MaprilBear/Keebi/KeebiPCB.png

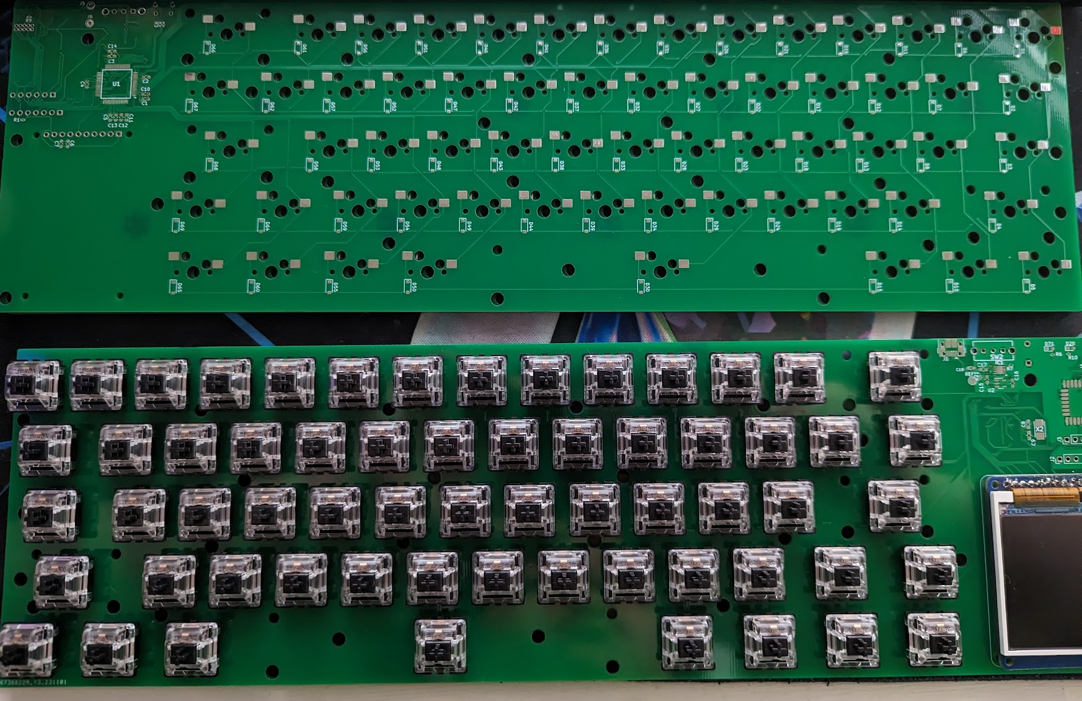
KeebiPCB.png
