MaprilBear/Keebi/sw/BGM220P/bluetooth_hid_keyboard/images/create_project.png

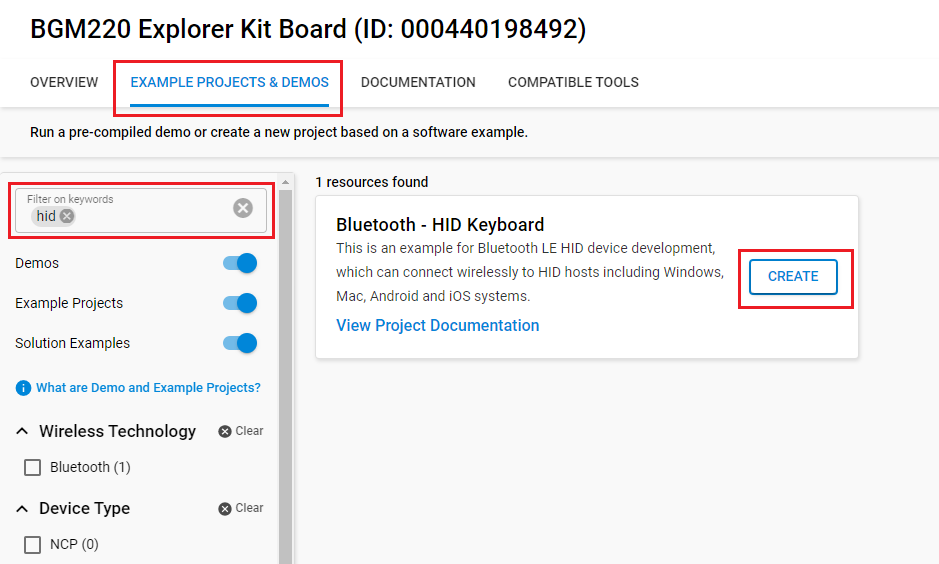
sw/BGM220P/bluetooth_hid_keyboard/images/create_project.png
