MaprilBear/Keebi/sw/BGM220P/bluetooth_hid_keyboard/images/logs.png

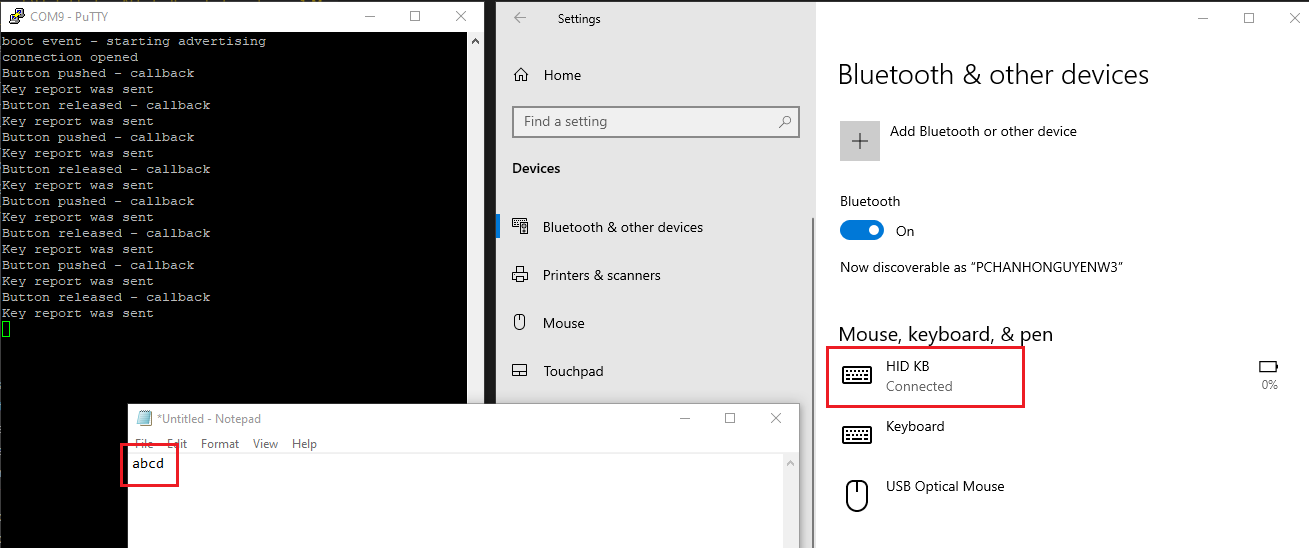
sw/BGM220P/bluetooth_hid_keyboard/images/logs.png
