MaprilBear/Keebi/BOM.xlsx

Sheet: Parts
Bill of Materials |  |  | 2022-03-10 | "not free" means you have to buy it |  | "free sample" means you have to order it
EE445L Spring 2022 |  |  | EE445L pays for the PCB | "Cabinet means in one of the six black cabinets in professsor's office (bring a print out of your SCH")
 |  |  | Items counting against the budget are in YELLOW | "Professor" means ask your professor quantity and style will vary (bring a print out of your SCH circuit)
Qty Note | REF DES Note (http://projects.ece.utexas.edu/valvano/wiki/doku.php?id=pcbartist:schematics) |  |  | "Box means in box in your professor's office (bring a print out of your SCH circuit) |  |  |  | TOTAL | $160.16 | Budget Total | $72.65 | ✨🎵Just ignore the stabs 🎵✨
Quantity | REF DES | Type | Description | Manufacturer | Mfg. P/N | Distributor | P/N | Unit cost | Cost |  | Where to get it? | Inventory
0 |  | ASM | 8-ohm speaker |  |  | AllElectronics | SK-840 | $0.60 | $0.00 | Speaker | professor | https://www.allelectronics.com/item/sk-840/speaker-8-ohm-40mm/1.html
0 |  | ASM | 9V battery snap, T-type |  |  | AllElectronics | BST-61 | $0.50 | $0.00 | Jumper2 | Box
0 |  | ASM | Black case, 5.5" x 2.6" x 1.1" | Hammond | 1593YALBK | Mouser | 546-1593YALBK | $8.50 | $0.00 |  |  | http://www.hammondmfg.com/pdf/1593Y.pdf
0 |  | ASM | Black Case 5.620" x 3.250" X 1.500" | Serpac | 151 | Digikey | SR151B-ND | $10.88 | $0.00 |  | professor
0 |  | ASM | Black case, 7.5" by 4.3" by 2.2" | Hammond | 1591ESBK | Mouser | 546-1591ES-BK | $8.71 | $0.00 |  | Box | http://www.hammondmfg.com/pdf/1591E.pdf
0 |  | ASM | Electret microphone | Panasonic |  | AllElectronics | MIKE-79 | $0.50 | $0.00 | electret | Cabinet
0 |  | CAP | Ceramic, X7R, 20%, 1 uF |  |  | Jameco | 81509 | $0.35 | $0.00 | Ceramic0.2 | Cabinet
0 |  | CAP | Ceramic, Z5U, -20/+80%, 0.47 uF | Kemet | C320C474M5U5TA | Digikey | 399-4309-ND | $0.40 | $0.00 | Ceramic | Cabinet
0 |  | CAP | Ceramic, Z5U, -20/+80%, 0.1 uF |  |  | Digikey | 399-4151-ND | $0.04 | $0.00 | Ceramic | Cabinet
0 |  | CAP | Ceramic, Z5U, -20/+80%, 0.033 uF |  |  | Digikey | 399-4298-ND | $0.40 | $0.00 | Ceramic | Cabinet
0 |  | CAP | Ceramic, Z5U, -20/+80%, 0.027uF |  |  |  |  | $0.40 | $0.00 | Ceramic | Cabinet
0 |  | CAP | Ceramic, Z5U, -20/+80%, 0.01 uF |  |  | Digikey | 399-4148-ND | $0.40 | $0.00 | Ceramic | Cabinet
0 |  | CAP | Ceramic, Z5U, -20/+80%, 4.7 nF |  |  | Digikey | 399-4188-ND | $0.40 | $0.00 | Ceramic | Cabinet
0 |  | CAP | Ceramic, Z5U, -20/+80%, 2.2 nF |  |  |  |  | $0.40 | $0.00 | Ceramic | Cabinet
0 |  | CAP | Ceramic, Z5U, -20/+80%, 1 nF |  |  |  |  | $0.40 | $0.00 | Ceramic | Cabinet
0 |  | CAP | Ceramic Z5U, -20/+80%, 470 pF |  |  |  |  | $0.03 | $0.00 | Ceramic | Cabinet
0 |  | CAP | Ceramic Z5U, -20/+80%, 330 pF |  |  |  |  | $0.03 | $0.00 | Ceramic | Cabinet
0 |  | CAP | Ceramic Z5U, -20/+80%, 220 pF |  |  |  |  | $0.03 | $0.00 | Ceramic | Cabinet
0 |  | CAP | Ceramic Z5U, -20/+80%, 100 pF |  |  |  |  | $0.03 | $0.00 | Ceramic | Cabinet
0 |  | CAP | Ceramic Z5U, -20/+80%, 22 pF |  |  |  |  | $0.03 | $0.00 | Ceramic | Cabinet
0 |  | CAP | Ceramic C0G, 10%, 10 pF | Murata 50V 5% | RDE5C1H100J0P1H03B | Digikey | 490-8629-ND | $0.31 | $0.00 | Ceramic | Cabinet | not required, we expect most students will create a system with the LaunchPad
0 |  | CAP-Tant | Tantalum, 16V, 20% 2.2 uF | AVX Corporation | TAP225M016CCS | Digikey | 478-8819-ND | $0.29 | $0.00 | tantalum | Cabinet
0 |  | CAP-Tant | Tantalum, 16V, 10% 4.7 uF |  |  | Digikey | 478-1904-ND | $0.22 | $0.00 | tantalum | Cabinet
0 |  | CAP-Tant | Tantalum, 20V, 10%, 1 uF |  |  | Digikey | 478-1833-ND | $0.32 | $0.00 | tantalum | Cabinet
0 |  | CAP-Tant | Tantalum, 20V 10%, 10uF |  |  | Digikey | 478-1840-ND | $0.56 | $0.00 | tantalum | Cabinet
0 |  | CAP-Tant | Tantalum, 35V, 10%, 0.47 uF |  |  | Jameco | 33531 | $0.19 | $0.00 | tantalum | Cabinet
0 |  | CAP-Elec | Electrolytic, 16V, 100 uF, cap 20%, ESR=20mV |  |  | Mouser | 661-APSF160E101MF05S | $0.38 | $0.00 | tantalum | Cabinet
0 |  | CON | 2 to 40 pin 0.1 in header (price per pin) |  |  | AllElectronics | SHS-40 | $0.02 | $0.00 | Jumper2 | Cabinet | https://www.allelectronics.com/item/shs-40/1-x-40-header-0.1-spacing/1.html
0 |  | CON | 2-pin shrouded header (mates with SBC-2) |  |  | AllElectronics | SBH-2 | $0.10 | $0.00 | Jumper2 | Cabinet | https://www.allelectronics.com/item/sbh-2/header-for-small-battery-conn-2.5mm-spacing/1.html
0 |  | DIODE | 1N914 diode | Fairchild | 1N914 | Digikey | 1N914B-ND | $0.05 | $0.00 | goes with SBH-2 | Cabinet | https://www.allelectronics.com/item/sbc-2/small-battery-connector-2.5mm-spacing/1.html
0 |  | CON | 2-pin shorting jumper, attaches to 0.1" male-male header | Harwin | M7581-05 | Mouser | 855-M7581-05 | $0.11 | $0.00 | goes with Jumper2 | Cabinet
0 |  | CON | Test point, black | Keystone Electronics | 5001 | Digikey | 36-5001K-ND | $0.23 | $0.00 | testpoint | Cabinet
0 |  | CON | Test point, orange | Keystone Electronics | 5003 | Digikey | 36-5003K-ND | $0.23 | $0.00 | testpoint | Cabinet
0 |  | CON | Test point, yellow | Keystone Electronics | 5004 | Digikey | 36-5004K-ND | $0.23 | $0.00 | testpoint | Cabinet
0 |  | CON | Test point, white | Keystone Electronics | 5002 | Digikey | 36-5002K-ND | $0.23 | $0.00 | testpoint | Cabinet
0 |  | CON | Test point, blue | Keystone Electronics | 5117 | Digikey | 36-5117-ND | $0.23 | $0.00 | testpoint | Cabinet
0 |  | CON | Test point, green | Keystone Electronics | 5116 | Digikey | 36-5116-ND | $0.23 | $0.00 | testpoint | Cabinet
0 |  | CON | Test point, red | Keystone Electronics | 5000 | Digikey | 36-5000K-ND | $0.23 | $0.00 | testpoint | Cabinet
0 |  | CON | 10-pin female connector | SamTec | BCS-110-L-S-TE | Digikey | SAM1011-10-ND | $1.98 | $0.00 |  | Cabinet
0 |  | CON | Socket for micro SD card | Molex | 473340001 | Digikey | WM3288CT-ND | $4.02 | $0.00 | MicroSD Slot | Cabinet | do not use, rather included on ST7735
0 |  | CON | USB Mini-B socket, board mount, surface mount | Molex | 56579-0576 | Mouser | 538-56579-0576 | $2.46 | $0.00 | USB_Mini-B | Cabinet
0 |  | LED | Red 1.6V 1mA 5mm diffused | Avago Technologies | HLMP-D150 | Digikey | 516-1323-ND | $0.29 | $0.00 | USB_Micro-B | Cabinet
0 |  | CON | USB Mini-B socket, board mount, through hole | Molex | 54819-0519 | Digikey | WM17115-ND | $0.65 | $0.00 | USB_Mini-B | Cabinet
0 |  | CON | BoosterPack connector | FCI | 67996-220HLF | Mouser | 609-3243-ND | $0.26 | $0.00 | BoosterPack | Cabinet
0 |  | CON | Logic Analyzer connector | FCI | 68021-208HLF | Digikey | 609-3344-ND | $0.27 | $0.00 | LogicAnalyzer | Cabinet
1 |  | CON | 2-pin battery cable (mates with SBH-2) |  |  | AllElectronics | SBC-2 | $0.27 | $0.27 | JTAG | Cabinet
0 |  | CON | 10 pin 2mm socket for Xbee (need two) | SamTec | SQT-110-01-F-S | Digikey | SAM9989-ND | $2.70 | $0.00 | XbeeModule | Cabinet
1 |  | CON | Micro USB Type B, surface mount | Hirose Connector | ZX62D-B-5PA8(30) | Mouser | 798-ZX62D-B-5PA830 | $0.47 | $0.47 | TM4C123GH6PM |  | not required, we expect most students will create a system with the LaunchPad
1 |  | CRYS | NX5032GA-16.000000 | NDK | NX5032GA-16.000000 | Digikey | 644-1037-1-ND | $0.51 | $0.51 | XTAL/NX5032 | Cabinet | not required, we expect most students will create a system with the LaunchPad
1 |  | CON | JTAG 1 by 5 male header |  |  |  |  | $0.29 | $0.29 | 1N914 | Cabinet
0 |  | IC | LM2937 3.3 V regulator TO220, 500mA | TI | LM2937ET-3.3/NOPB | Digikey | LM2937ET-3.3-ND | $1.17 | $0.00 | LM2937-3.3 | Cabinet
0 |  | IC | LP2950 3.3V regulator, 100 mA TO-92 | TI | LP2950-33LPRE3 | Digikey | 296-31455-1-ND | $0.19 | $0.00 | LP2950-CZ-3.3 | Cabinet
0 |  | IC | 78M05 500mA 5V TO-220 regulator | National | LM78M05 | Jameco | 192233 | $0.19 | $0.00 | LM7805CT | Cabinet
0 |  | IC | OPA4350 quad op amp | TI | OPA4350UA | Mouser | 595-OPA4350UA | $12.15 | $0.00 | OPA4350 | not free
0 |  | IC | TLV5616 12-bit DAC | TI | TLV5616CP | Mouser | 595-TLV5616CP | $10.09 | $0.00 | TLV5616 | not free
0 |  | IC | TLV5618 dual 12-bit DAC | TI | TLV5618 | Mouser | TLV5618ACP | $14.18 | $0.00 | TLV5618 | not free
0 |  | IC | INA122P instrumentation amp | TI | INA122P | Mouser | 595-INA122P | $9.09 | $0.00 | INA122 | Cabinet or free sample
0 |  | IC | OPA2350 dual op amp | TI | OPA2350PA | obsolete |  |  | $0.00 | OPA2350 | Cabinet or free sample |  |  | 1 KD
0 |  | IC | TLC2274 quad op amp | TI | TLC2274ACN | Mouser | 595-TLC2274ACN | $3.06 | $0.00 | TLC2274 | not free |  |  | 2 HD
0 |  | IC | TPA731 audio amp (pin 1 low) 700mW | TI | TPA731D | Mouser | 595-TPA731D | $2.90 | $0.00 | TPA731 | not free |  |  | 3 AD
0 |  | IC | TPA751 audio amp (pin 1 high) 700mW | TI | TPA751D | Mouser | 595-TPA751D | $2.31 | $0.00 | TPA731 | not free |  |  | 4 JD
0 |  | IC | LM4041CILPR shunt diode reference | TI | LM4041CILPR | Mouser | 595-LM4041CILPR | $1.21 | $0.00 | LM4041 | Cabinet or free sample |  |  | 5 CD
0 |  | IC | L293 Motor H bridge | TI | L293NE | Digikey | 296-9519-5-ND | $3.50 | $0.00 | L293 | Cabinet |  |  | 7 MD
0 |  | IC | 74HC595 |  |  | Jameco | 46105 | $0.40 | $0.00 |  | Cabinet |  |  | 8 ED
0 |  | IC | 74HC165 |  |  | Jameco | 45495 | $0.30 | $0.00 |  | Cabinet |  |  | 9 FD
0 |  | IC | 74HCT125N | TI | SN74HCT125N | Mouser | 595-SN74HCT125N | $0.53 | $0.00 |  | Cabinet
0 |  | IC | RS232 driver | STMicroelectronics | ST232CN | Jameco | 2001171 | $0.58 | $0.00 | ST232 | Cabinet |  |  | 0 ND
0 |  | JACK | DC Power MALE 2.1mm |  |  | Jameco | 101179 | $0.55 | $0.00 | PowerJack | Cabinet |  |  | * LD
0 |  | JACK | Stereo Jack, or audio jack |  |  | AllElectronics | MJW-12 | $0.09 | $0.00 | HeadphoneJack | Cabinet |  | 87YY3212A
0 |  | KEY | 3 by 4 common bus (D), keypad | Grayhill | 87YY3212A-506 |  |  | $2.99 | $0.00 | 87YY3212A | Box | http://docs.bgmicro.com/pdf/swt1109.pdf
1 |  | LCD | 18-bit color 128*160 1.8" TFT LCD display | Sitronix | ST7735R | Adafruit | 358 | $19.96 | $19.96 | LEDT1.75 | Cabinet
0 |  | LED | Yellow 2mA 5mm diffused | Avago Technologies | HLMP-4719 | Digikey | 516-1326-ND | $0.29 | $0.00 | LEDT1.75 | Cabinet
0 |  | LED | Orange 10mA 5mm diffused | Avago Technologies | HLMP-D401 | Digikey | 516-1330-ND | $0.29 | $0.00 | LEDT1.75 | Cabinet
0 |  | LED | Blue 10mA 5mm diffused |  |  |  |  | $0.99 | $0.00 | LEDT1.75 | Cabinet | warning, the blue LEDs are very bright
1 |  | PCB | PCB plus shipping | JLCPCB |  | JLCPCB |  | $40.00 | $40.00
0 |  | POT | 20K LINEAR SLIDE POT | Bourns | PTA2043-2015CPB103 | Mouser | 652-PTA20432015CPB10 | $1.28 | $0.00 |  | Cabinet
0 |  | POT | 10 K one-turn potentiometer |  |  |  |  | $0.15 | $0.00 | SquarePot | Professor
0 |  | POT | 20 K one-turn potentiometer |  |  |  |  | $0.15 | $0.00 | SquarePot | Professor
0 |  | RES | Carbon 1/6W, 5%, 100 | Yageo | CFR-12JB-100R | Digikey | 100EBK-ND | $0.02 | $0.00 | 0.125Wresistor | Cabinet
0 |  | RES | Carbon 1/6W, 5%, 220 | Yageo | CFR-12JB-220R | Digikey | 220EBK-ND | $0.02 | $0.00 | 0.125Wresistor | Cabinet
0 |  | RES | Carbon 1/6W, 5%, 270 | Yageo | CFR-12JB-270R | Digikey | 270EBK-ND | $0.02 | $0.00 | 0.125Wresistor | Cabinet
0 |  | RES | Carbon 1/6W, 5%, 330 | Yageo | CFR-12JB-330R | Digikey | 330EBK-ND | $0.02 | $0.00 | 0.125Wresistor | Cabinet
0 |  | RES | Carbon 1/6W, 5%, 470 | Yageo | CFR-12JB-470R | Digikey | 470EBK-ND | $0.02 | $0.00 | 0.125Wresistor | Cabinet
0 |  | RES | Carbon 1/6W, 5%, 510 | Yageo | CFR-12JB-510R | Digikey | 510EBK-ND | $0.02 | $0.00 | 0.125Wresistor | Cabinet
0 |  | RES | Carbon 1/6W, 5%, 680 | Yageo | CFR-12JB-680R | Digikey | 680EBK-ND | $0.02 | $0.00 | 0.125Wresistor | Cabinet
0 |  | RES | Carbon 1/6W, 5%, 820 | Yageo | CFR-12JB-820R | Digikey | 820EBK-ND | $0.02 | $0.00 | 0.125Wresistor | Cabinet
0 |  | RES | Carbon 1/6W, 5%, 1K | Yageo | CFR-12JB-1K0 | Digikey | 1.0KEBK-ND | $0.02 | $0.00 | 0.125Wresistor | Cabinet
0 |  | RES | Carbon 1/6W, 5%, 1.2K | Yageo | CFR-12JB-1K2 | Digikey | 1.2KEBK-ND | $0.02 | $0.00 | 0.125Wresistor | Cabinet
0 |  | RES | Carbon 1/6W, 5%, 1.5K | Yageo | CFR-12JB-1K5 | Digikey | 1.5KEBK-ND | $0.02 | $0.00 | 0.125Wresistor | Cabinet
0 |  | RES | Carbon 1/6W, 5%, 1.8K | Yageo | CFR-12JB-1K8 | Digikey | 1.8KEBK-ND | $0.02 | $0.00 | 0.125Wresistor | Cabinet
0 |  | RES | Carbon 1/6W, 5%, 2.0K | Yageo | CFR-12JB-2K0 | Digikey | 2.0KEBK-ND | $0.02 | $0.00 | 0.125Wresistor | Cabinet
0 |  | RES | Carbon 1/6W, 5%, 2.2K | Yageo | CFR-12JB-2K2 | Digikey | 2.2KEBK-ND | $0.02 | $0.00 | 0.125Wresistor | Cabinet
0 |  | RES | Carbon 1/6W, 5%, 2.7K | Yageo | CFR-12JB-2K7 | Digikey | 2.7KEBK-ND | $0.02 | $0.00 | 0.125Wresistor | Cabinet
0 |  | RES | Carbon 1/6W, 5%, 3.3K | Yageo | CFR-12JB-3K3 | Digikey | 3.3KEBK-ND | $0.02 | $0.00 | 0.125Wresistor | Cabinet
0 |  | RES | Carbon 1/6W, 5%, 3.9K | Yageo | CFR-12JB-3K9 | Digikey | 3.9KEBK-ND | $0.02 | $0.00 | 0.125Wresistor | Cabinet
0 |  | RES | Carbon 1/6W, 5%, 4.7K | Yageo | CFR-12JB-4K7 | Digikey | 4.7KEBK-ND | $0.02 | $0.00 | 0.125Wresistor | Cabinet
0 |  | RES | Carbon 1/6W, 5%, 5.1K | Yageo | CFR-12JB-5K1 | Digikey | 5.1KEBK-ND | $0.02 | $0.00 | 0.125Wresistor | Cabinet
0 |  | RES | Carbon 1/6W, 5%, 5.6K | Yageo | CFR-12JB-5K6 | Digikey | 5.6KEBK-ND | $0.02 | $0.00 | 0.125Wresistor | Cabinet
0 |  | RES | Carbon 1/6W, 5%, 6.8K | Yageo | CFR-12JB-6K8 | Digikey | 6.8KEBK-ND | $0.02 | $0.00 | 0.125Wresistor | Cabinet
0 |  | RES | Carbon 1/6W, 5%, 8.2K | Yageo | CFR-12JB-8K2 | Digikey | 8.2KEBK-ND | $0.02 | $0.00 | 0.125Wresistor | Cabinet
0 |  | RES | Carbon 1/6W, 5%, 10K | Yageo | CFR-12JB-10K | Digikey | 10KEBK-ND | $0.02 | $0.00 | 0.125Wresistor | Cabinet
0 |  | RES | Carbon 1/6W, 5%, 12K | Yageo | CFR-12JB-12K | Digikey | 12KEBK-ND | $0.02 | $0.00 | 0.125Wresistor | Cabinet
0 |  | RES | Carbon 1/6W, 5%, 15K | Yageo | CFR-12JB-15K | Digikey | 15KEBK-ND | $0.02 | $0.00 | 0.125Wresistor | Cabinet | http://www.kemet.com/kemet/web/homepage/kechome.nsf/vapubfiles/F3101_GoldMax.pdf/$file/F3101_GoldMax.pdf
0 |  | RES | Carbon 1/6W, 5%, 18K | Yageo | CFR-12JB-18K | Digikey | 18KEBK-ND | $0.02 | $0.00 | 0.125Wresistor | Cabinet
0 |  | RES | Carbon 1/6W, 5%, 20K | Yageo | CFR-12JB-20K | Digikey | 20KEBK-ND | $0.02 | $0.00 | 0.125Wresistor | Cabinet
0 |  | RES | Carbon 1/6W, 5%, 22K | Yageo | CFR-12JB-22K | Digikey | 22KEBK-ND | $0.02 | $0.00 | 0.125Wresistor | Cabinet
0 |  | RES | Carbon 1/6W, 5%, 27K | Yageo | CFR-12JB-27K | Digikey | 27KEBK-ND | $0.02 | $0.00 | 0.125Wresistor | Cabinet
0 |  | RES | Carbon 1/6W, 5%, 36K | Yageo | CFR-12JB-36K | Digikey | 36KEBK-ND | $0.02 | $0.00 | 0.125Wresistor | Cabinet
0 |  | RES | Carbon 1/6W, 5%, 33K | Yageo | CFR-12JB-33K | Digikey | 33KEBK-ND | $0.02 | $0.00 | 0.125Wresistor | Cabinet
0 |  | RES | Carbon 1/6W, 5%, 39K | Yageo | CFR-12JB-39K | Digikey | 39KEBK-ND | $0.02 | $0.00 | 0.125Wresistor | Cabinet
0 |  | RES | Carbon 1/6W, 5%, 47K | Yageo | CFR-12JB-47K | Digikey | 47KEBK-ND | $0.02 | $0.00 | 0.125Wresistor | Cabinet
0 |  | RES | Carbon 1/6W, 5%, 51K | Yageo | CFR-12JB-51K | Digikey | 51KEBK-ND | $0.02 | $0.00 | 0.125Wresistor | Cabinet
0 |  | RES | Carbon 1/6W, 5%, 56K | Yageo | CFR-12JB-56K | Digikey | 56KEBK-ND | $0.02 | $0.00 | 0.125Wresistor | Cabinet
0 |  | RES | Carbon 1/6W, 5%, 68K | Yageo | CFR-12JB-68K | Digikey | 68KEBK-ND | $0.02 | $0.00 | 0.125Wresistor | Cabinet
0 |  | RES | Carbon 1/6W, 5%, 82K | Yageo | CFR-12JB-82K | Digikey | 82KEBK-ND | $0.02 | $0.00 | 0.125Wresistor | Cabinet
0 |  | RES | Carbon 1/6W, 5%, 100K | Yageo | CFR-12JB-100K | Digikey | 100KEBK-ND | $0.02 | $0.00 | 0.125Wresistor | Cabinet
0 |  | RES | Carbon 1/6W, 5%, 120K | Yageo | CFR-12JB-120K | Digikey | 120KEBK-ND | $0.02 | $0.00 | 0.125Wresistor | Cabinet
0 |  | RES | Carbon 1/6W, 5%, 150K | Yageo | CFR-12JB-150K | Digikey | 150KEBK-ND | $0.02 | $0.00 | 0.125Wresistor | Cabinet
0 |  | RES | Carbon 1/6W, 5%, 180K | Yageo | CFR-12JB-180K | Digikey | 180KEBK-ND | $0.02 | $0.00 | 0.125Wresistor | Cabinet
0 |  | RES | Carbon 1/6W, 5%, 200K | Yageo | CFR-12JB-200K | Digikey | 200KEBK-ND | $0.02 | $0.00 | 0.125Wresistor | Cabinet
0 |  | RES | Carbon 1/6W, 5%, 220K | Yageo | CFR-12JB-220K | Digikey | 220KEBK-ND | $0.02 | $0.00 | 0.125Wresistor | Cabinet
0 |  | RES | Carbon 1/6W, 5%, 240K | Yageo | CFR-12JB-240K | Digikey | 240KEBK-ND | $0.02 | $0.00 | 0.125Wresistor | Cabinet
0 |  | RES | Carbon 1/6W, 5%, 270K | Yageo | CFR-12JB-270K | Digikey | 270KEBK-ND | $0.02 | $0.00 | 0.125Wresistor | Cabinet
0 |  | RES | Carbon 1/6W, 5%, 330K | Yageo | CFR-12JB-330K | Digikey | 330KEBK-ND | $0.02 | $0.00 | 0.125Wresistor | Cabinet
0 |  | RES | Carbon 1/6W, 5%, 390K | Yageo | CFR-12JB-390K | Digikey | 390KEBK-ND | $0.02 | $0.00 | 0.125Wresistor | Cabinet
0 |  | RES | Carbon 1/6W, 5%, 470K | Yageo | CFR-12JB-470K | Digikey | 470KEBK-ND | $0.02 | $0.00 | 0.125Wresistor | Cabinet
0 |  | RES | Carbon 1/6W, 5%, 510K | Yageo | CFR-12JB-510K | Digikey | 510KEBK-ND | $0.02 | $0.00 | 0.125Wresistor | Cabinet
0 |  | RES | Carbon 1/6W, 5%, 560K | Yageo | CFR-12JB-560K | Digikey | 560KEBK-ND | $0.02 | $0.00 | 0.125Wresistor | Cabinet
0 |  | RES | Carbon 1/6W, 5%, 680K | Yageo | CFR-12JB-680K | Digikey | 680KEBK-ND | $0.02 | $0.00 | 0.125Wresistor | Cabinet
0 |  | RES | Carbon 1/6W, 5%, 820K | Yageo | CFR-12JB-820K | Digikey | 820KEBK-ND | $0.02 | $0.00 | 0.125Wresistor | Cabinet
0 |  | RES | Carbon 1/6W, 5%, 1M | Yageo | CFR-12JB-1M0 | Digikey | 1.0MEBK-ND | $0.02 | $0.00 | 0.125Wresistor | Cabinet
0 |  | RES | Carbon 1/6W, 5%, 10M | Yageo | CFR-12JB-10M | Digikey | 10MEBK-ND | $0.02 | $0.00 | 0.125Wresistor | Cabinet
0 |  | SW | Tactile Switch, surface mount | C&K Components | KSC353JLFG | Mouser | 611-KSC353JLFG | $0.86 | $0.00 | KSC353JLFG | Cabinet
0 |  | SW | B3F tactile push button switch | Omron Electronics | B3F-1052 | Digikey | SW405-ND | $0.17 | $0.00 | B3F-1050 | Cabinet
0 |  | SW | Black Off board momentary push buttom |  |  | AllElectronics | MPB-5 | $0.35 | $0.00 | OffBoardSwitch | Professor
0 |  | SW | Red Off board momentary push buttom |  |  | AllElectronics | MPB-1 | $0.35 | $0.00 | OffBoardSwitch | Professor
0 |  | SW | On/off power switch |  |  |  |  | $0.85 | $0.00 | OffBoardPowerSwitch | Professor
0 |  | TRAN | PN2222 NPN transistor | Fairchild Semiconductor | PN2222 | Digikey | PN2222BU-ND | $0.13 | $0.00 | 2N2222 | Cabinet | be careful to get pins 1 and 3 correct, there are two versions of the chip: 2N2222 and PN2222
0 |  | TRAN | TIP120 Darlington NPN, TO220 | Fairchild | TIP120 | Digikey | TIP120-ND | $0.68 | $0.00 | TIP120 | Cabinet
0 |  | TRAN | TIP125 Darlington PNP, TO220 | Fairchild | TIP125 | Digikey | TIP125TU-ND | $0.67 | $0.00 | TIP125 | Cabinet
0 |  | TRAN | IRF540 MOSFET N-channel, TO220 |  | IRF540 | Digikey | IRF540NPBF-ND | $1.95 | $0.00 | IRF540 | Cabinet
1 |  | SW | 65x RGB MX Type Key Switch | Gateron | KS-8 | Amazon | KS-8 | $20.00 | $20.00
1 |  | ASM | Custom 3D printed shell | TIW | - | TIW | - | $0.00 | $0.00
1 |  | CPU | BGM220PC22HNA Bluetooth Module | Silicon Labs | BGM220PC22HNA2R | Mouser | 634-BGM220PC22HNA2R | $10.88 | $10.88
1 |  | MISC | Hot-swappable PCB Socket Sip Socket x70 | IJKT | KS-2P02B01 | Amazon |  | $9.90 | $9.90 |  | https://www.amazon.com/dp/B0972HB9GY?ref=ppx_yo2ov_dt_b_product_details&th=1
1 |  | POWER | LDO Voltage Regulators Cap-Free NMOS 400mA | Texas Instruments | TPS73633DBV | Mouser | 595-TPS73633DBVRG4 | $1.50 | $1.50 |  | https://www.mouser.com/ProductDetail/Texas-Instruments/TPS73633DBVRG4?qs=6zVL%252ByCp0mpknSjwGe1Hbg%3D%3D
1 |  | POWER | Power Switch IC | Texas Instruments | TPS2113ADRBR | Mouser | 595-TPS2113ADRBR | $1.87 | $1.87 |  | https://www.mouser.com/ProductDetail/Texas-Instruments/TPS2113ADRBR?qs=g%2FrhRe7LVpRsXhRevikZ7Q%3D%3D
1 |  | MCU | ARM Microcontroller | Texas Instruments | TM4C123GH6PMI7 | Mouser | 595-TM4C123GH6PMI7 | $12.50 | $12.50 |  | https://www.mouser.com/ProductDetail/Texas-Instruments/TM4C123GH6PMI7?qs=m%2F7bTylgptcEEuXHNU46tA%3D%3D
1 |  | SW | SPDT Slide Switch | CUI Devices | SLW-121586-5A-D | Mouser | 179-SLW-121586-5A-D | $0.45 | $0.45
2 |  | CAP | Ceramic C0G, 1%, 10pF | KYOCERA AVX | 06035A100F4T4A | Mouser | 581-06035A100F4T4A | $0.42 | $0.84
100 |  | DIODE | 1N4448W Diode (full tape of 100) | Diodes Incorporated | 1N4448WQ-7-F | Mouser | 621-1N4448WQ-7-F | $0.06 | $5.80
10 |  | DIODE | X7R 1uF 10% | YAGEO | CC0603KRX7R7BB105 |  | 603-CC603KRX7R7BB105 | $0.06 | $0.56
10 |  | DIODE | X7R 0.1uF 5% | KYOCERA AVX | 06035C104JAT4A |  | 581-06035C104JAT4A | $0.03 | $0.31
10 |  | DIODE | X5R 4.7uF 10% | KYOCERA AVX | 06036D475KAT2A |  | 581-06036D475K | $0.09 | $0.90
10 |  | DIODE | X7R 10nF 10% | KYOCERA AVX | 06035C103KAT2A |  | 581-06035C103K | $0.02 | $0.23
10 |  | DIODE | X5R 2.2uF 10% | KYOCERA AVX | 06036D225KAT2A |  | 581-06036D225K | $0.08 | $0.76
1 |  |  | Gateron V2 Clear Stabilizers | Gateron | V2 | Amazon |  | $15.00 | $15.00 |  | https://www.amazon.com/dp/B0BV2CKDJW?psc=1&smid=A3HH0O874SI0OR
1 |  |  | 165-key PBT Keycap Set | XVX |  | Amazon |  | $15.00 | $15.00 |  | https://www.amazon.com/dp/B09JQPMZBG?psc=1&smid=AZ1RQDED92VC
3 |  | LED | LED RED CLEAR 0603 SMD | Kingbright | APTD1608SEC/J3 | Mouser | 604-APTD1608SEC/J3 | $0.72 | $2.16 |  | https://www.mouser.com/ProductDetail/Kingbright/APTD1608SEC-J3?qs=6pLj%252BqlhfwAhstDKTOglEA%3D%3D
0 |  | SCREW | 10-pack M2 x 4 mm flat-head screws | Generic |  | Amazon |  | $3.99 | $0.00 |  | https://www.amazon.com/Deal4GO-10-Pack-Replacement-Phillips-Heatsink/dp/B0B373RNJP

Sheet: SurfaceMountParts
Quantity | REF DES | Type | Description | Manufacturer | Mfg. P/N | Distributor | P/N | Unit cost | Cost | PCB Artist | Where to get it?
0 |  | CAP | 0805 0.22 uF X7R ceramic |  |  |  |  | $0.14 | $0.00 | Ceramic0805 | Little box of surface mount parts
0 |  | CAP | 0805 220 pF C0G ceramic |  |  |  |  | $0.35 | $0.00 | Ceramic0805 | Little box of surface mount parts
0 |  | RES | 0805 1.1k 1% |  |  |  |  | $0.04 | $0.00 | 0.1WresistorSM805 | Little box of surface mount parts
0 |  | RES | 0805 10k 1% |  |  |  |  | $0.04 | $0.00 | 0.1WresistorSM805 | Little box of surface mount parts
0 |  | RES | 0805 20k 1% |  |  |  |  | $0.04 | $0.00 | 0.1WresistorSM805 | Little box of surface mount parts
0 |  | RES | 0805 25.5k 1% |  |  |  |  | $0.04 | $0.00 | 0.1WresistorSM805 | Little box of surface mount parts
0 |  | RES | 0805 100k 1% |  |  |  |  | $0.04 | $0.00 | 0.1WresistorSM805 | Little box of surface mount parts
