MaprilBear/Keebi/hw/KeyboardPCB/models/ti_TLV5618AIP.stp

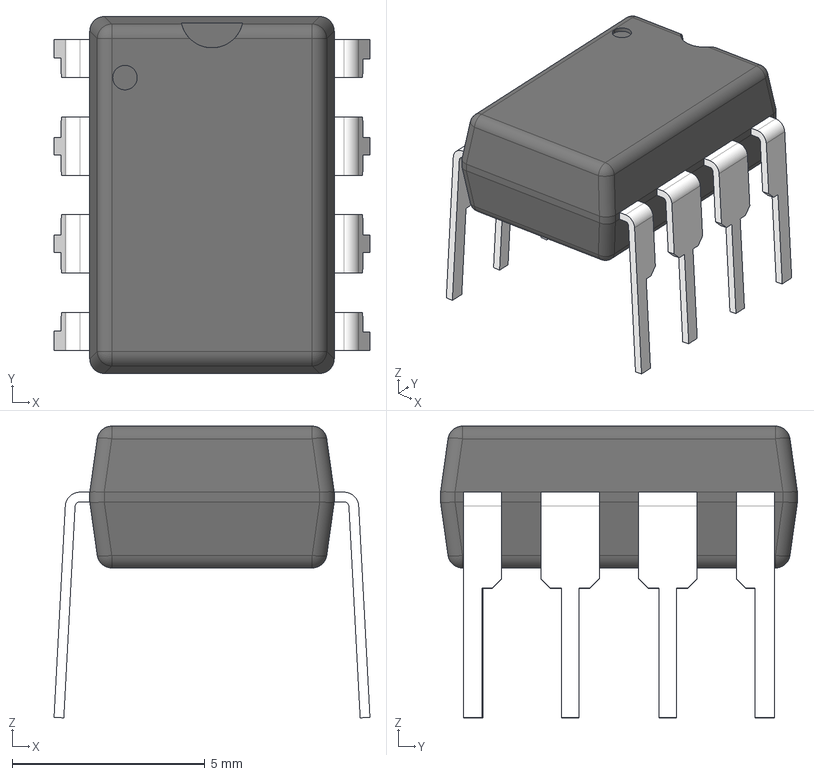
[picture p6: CAD file, 2023-10-28]
hw/KeyboardPCB/models/ti_TLV5618AIP.stp
8.20 x 9.27 x 7.58 mm
BODY_P0008A
LEAD_P0008A x 4
LD_LHALF_P0008A x 2
LD_RHALF_P0008A x 2
