MaprilBear/Keebi/hw/KeyboardPCB/models/adafruit_st7735r.stp

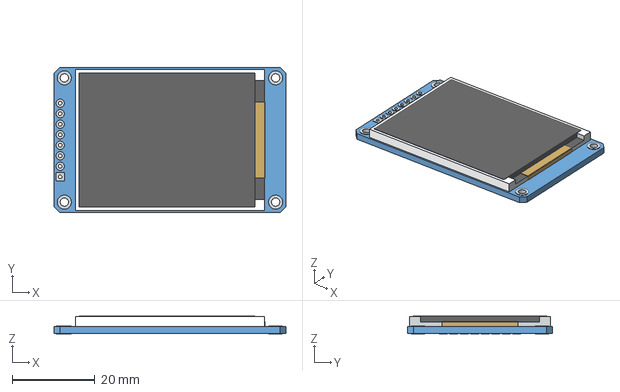
[picture p7: CAD file, 2023-10-28]
hw/KeyboardPCB/models/adafruit_st7735r.stp
56.0 x 35.0 x 4.25 mm
