MaprilBear/Keebi/hw/KeyboardPCB/models/ti_LM4041CILPR.step

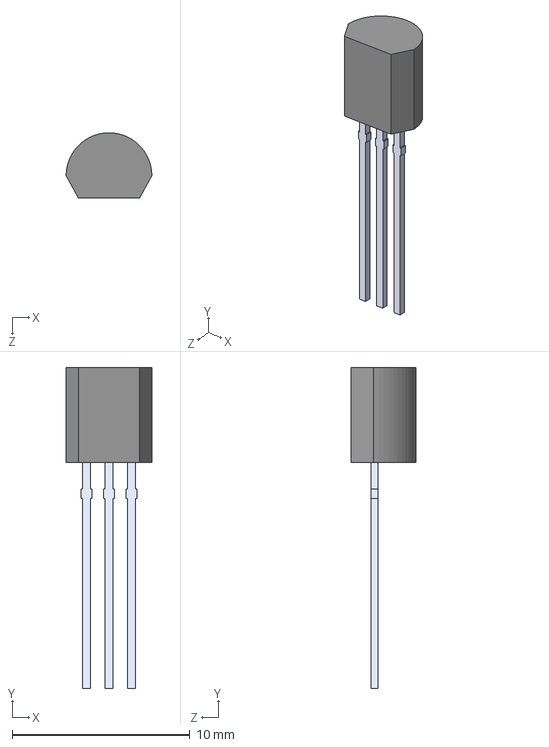
[picture p8: CAD file, 2023-10-28]
hw/KeyboardPCB/models/ti_LM4041CILPR.step
4.82 x 18.0 x 3.68 mm
