MaprilBear/Keebi/hw/KeyboardPCB/models/ai_thinker_ESP8266-01.step

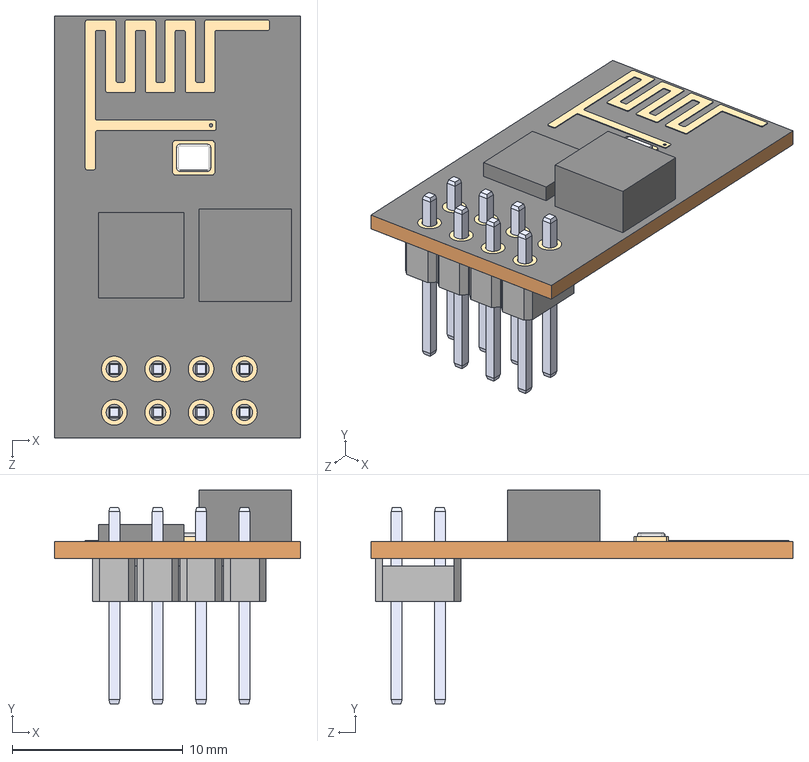
[picture p9: CAD file, 2023-10-28]
hw/KeyboardPCB/models/ai_thinker_ESP8266-01.step
14.4 x 12.5 x 24.7 mm
