MaprilBear/Keebi/hw/KeyboardPCB/models/vishay_IRLD024PBF.stp

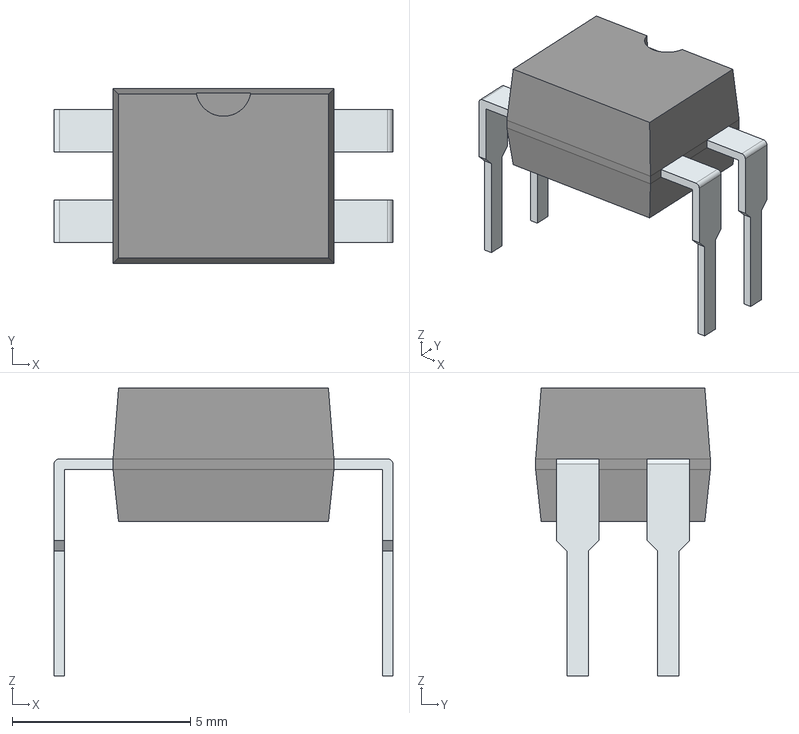
[picture p10: CAD file, 2023-10-12]
hw/KeyboardPCB/models/vishay_IRLD024PBF.stp
9.51 x 4.90 x 8.07 mm
PinsArrayLR
