MaprilBear/Keebi/hw/KeyboardPCB/KeyboardPCB.kicad_pcb

## KiCad design hw/KeyboardPCB/KeyboardPCB.kicad_pcb (2023-11-10)

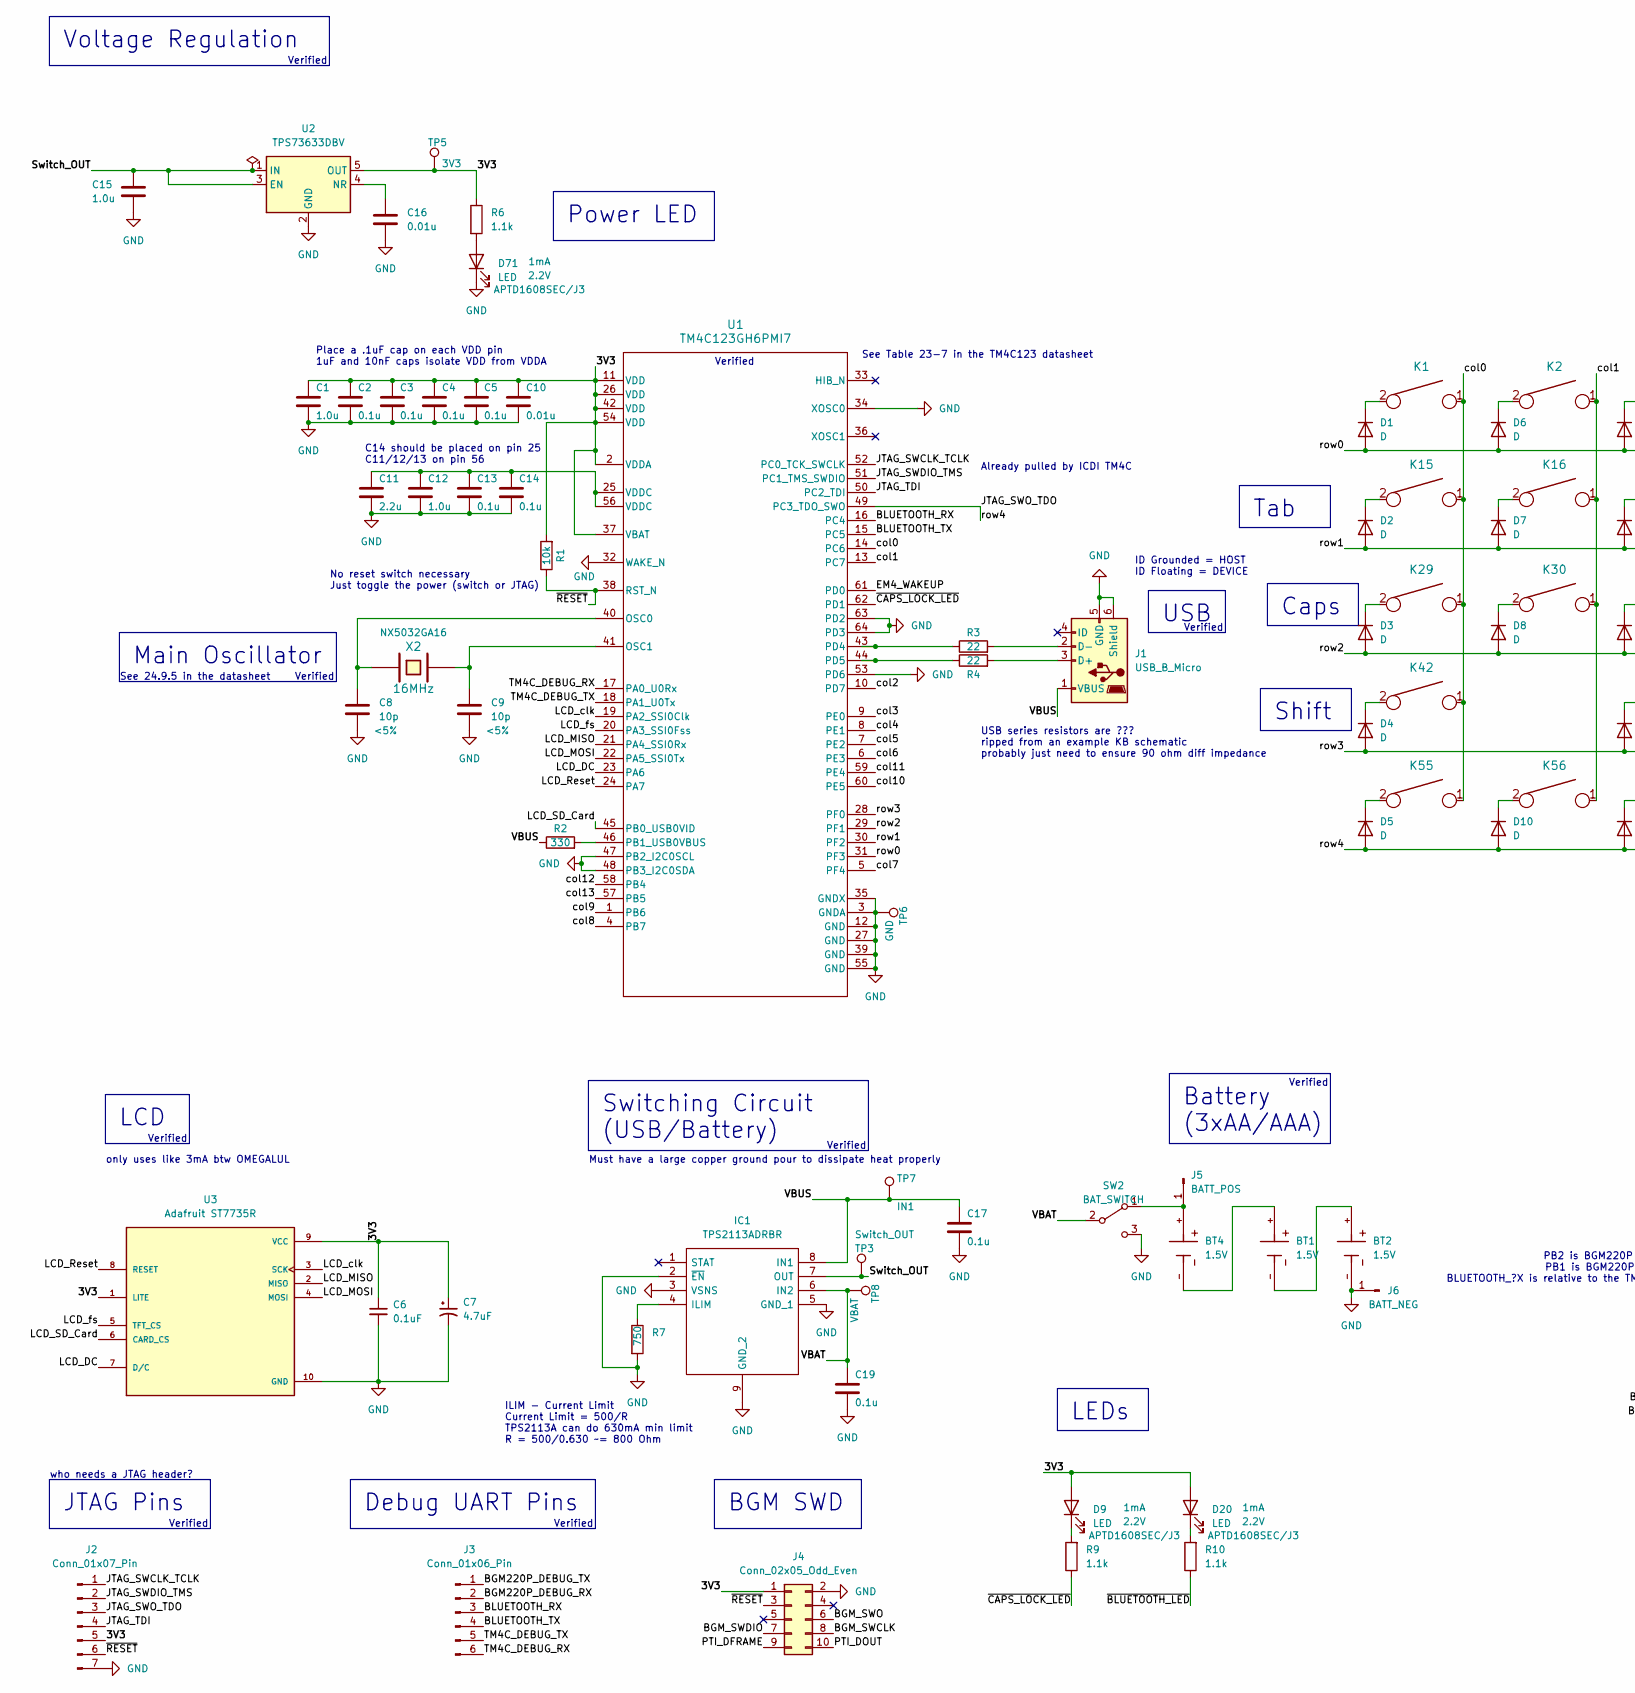
[picture p11: schematic KeyboardPCB.kicad_sch, part in row 1, column 1]

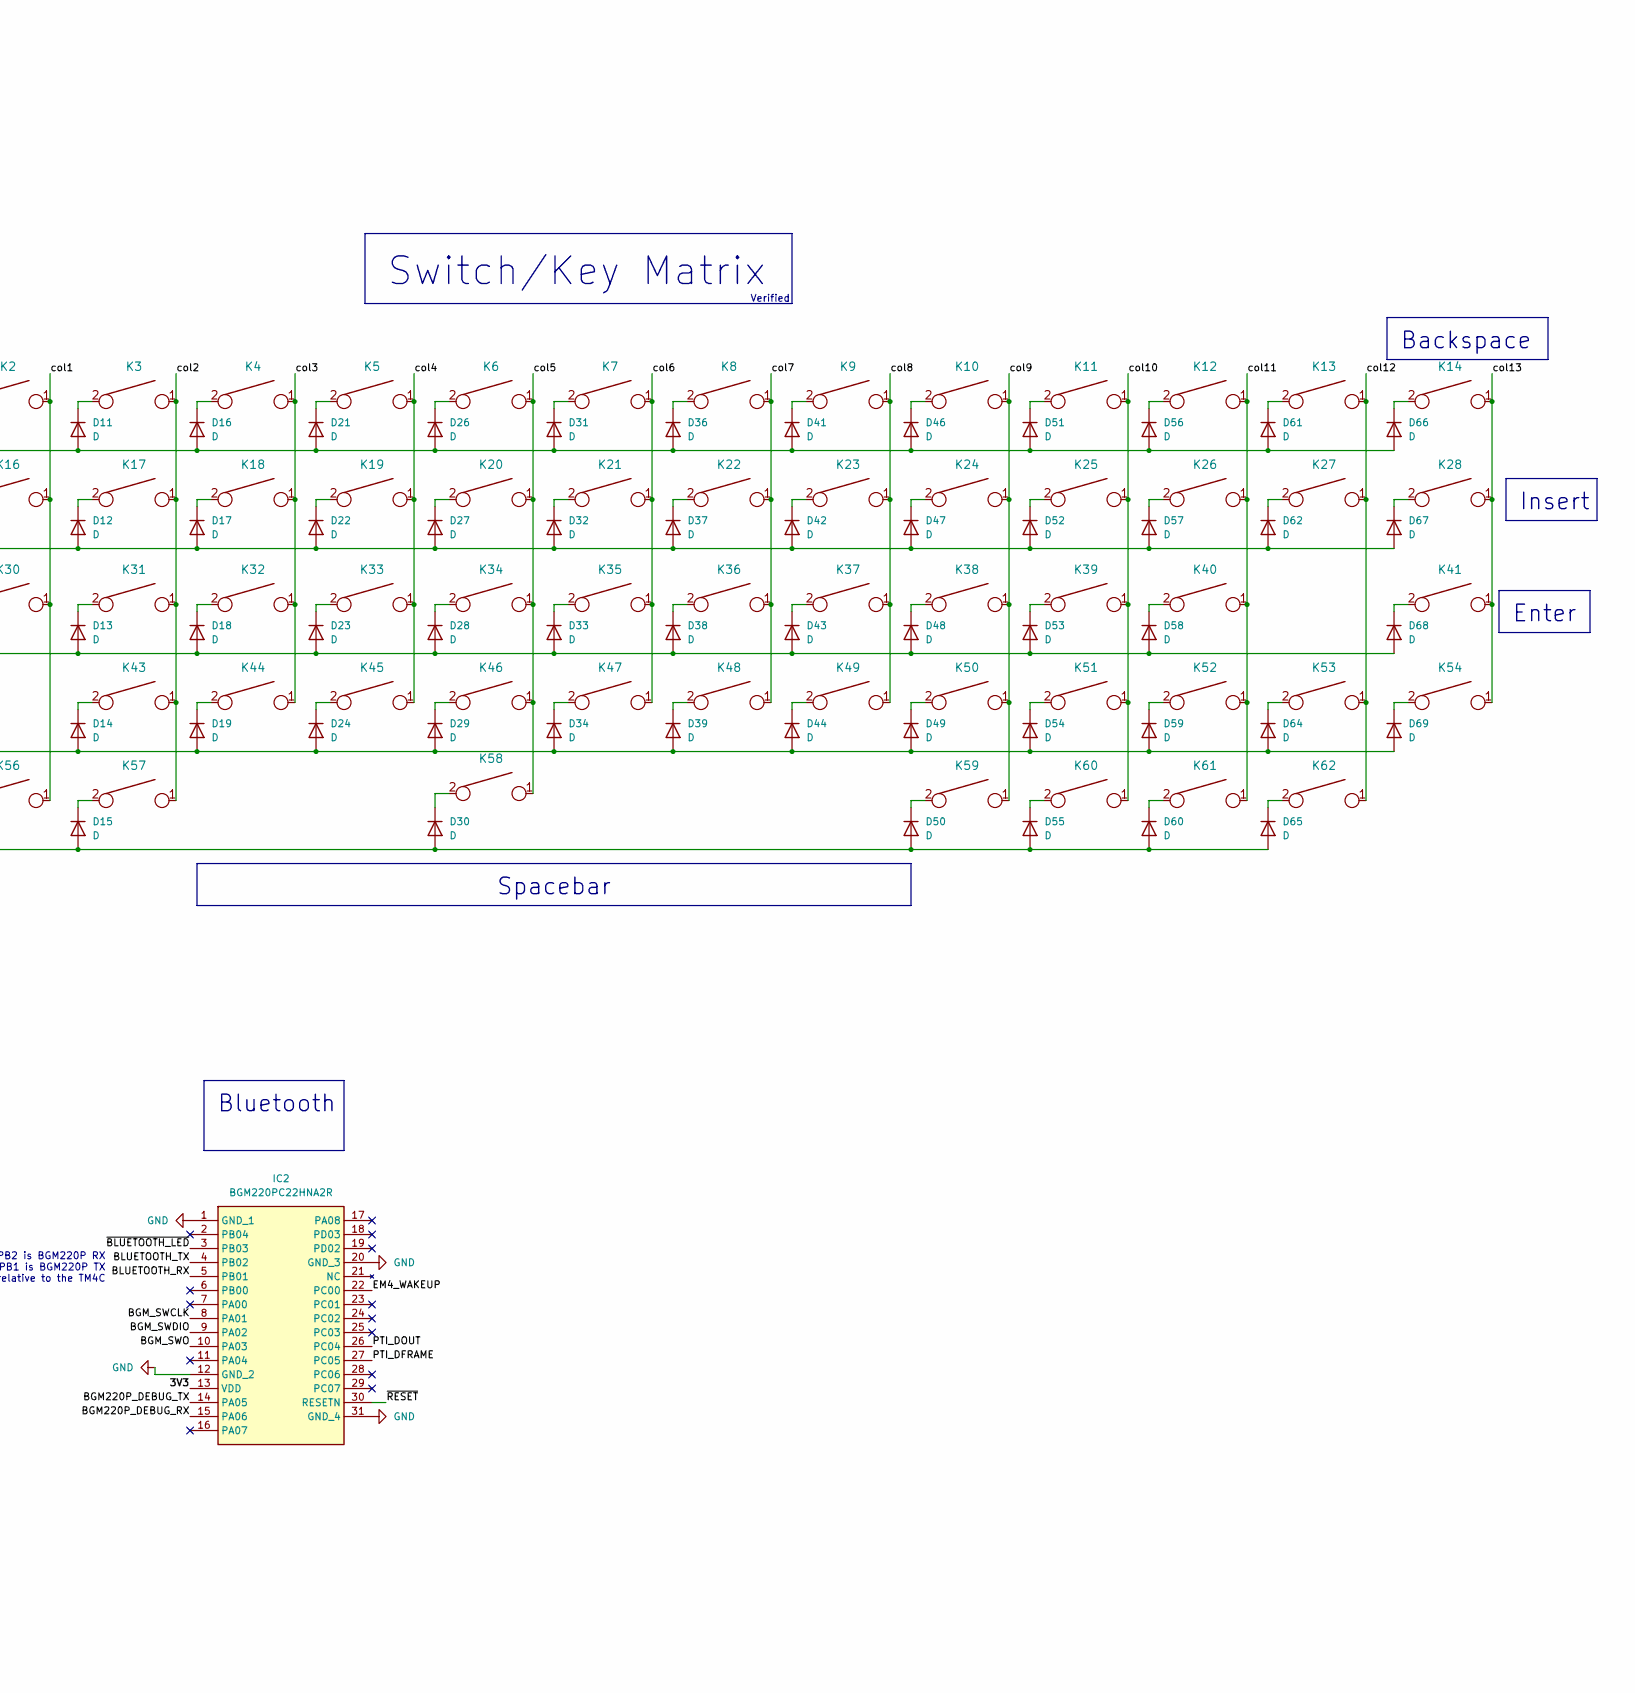
[picture p12: schematic KeyboardPCB.kicad_sch, part in row 1, column 2]

Parts:
BT1, BT2, BT4: 1.5V; PARTREV A
C1, C12, C15: 1.0u; C_0603_1608Metric_Pad1.08x0.95mm_HandSolder
C2, C3, C4, C5, C13, C14, C17, C19: 0.1u; C_0603_1608Metric_Pad1.08x0.95mm_HandSolder
C6: 0.1uF; C_0603_1608Metric_Pad1.08x0.95mm_HandSolder
C7: 4.7uF; C_0603_1608Metric_Pad1.08x0.95mm_HandSolder
C8, C9: 10p; C_0603_1608Metric_Pad1.08x0.95mm_HandSolder; Tolerance <5%
C10, C16: 0.01u; C_0603_1608Metric_Pad1.08x0.95mm_HandSolder
C11: 2.2u; C_0603_1608Metric_Pad1.08x0.95mm_HandSolder
D1, D2, D3, D4, D5, D6, D7, D8, D10, D11, D12, D13, D14, D15, D16, D17, D18, D19, D21, D22, D23, D24, D26, D27, D28, D29, D30, D31, D32, D33, D34, D36, D37, D38, D39, D41, D42, D43, D44, D46, D47, D48, D49, D50, D51, D52, D53, D54, D55, D56, D57, D58, D59, D60, D61, D62, D64, D65, D66, D67, D68, D69: D; D_SOD-123
D9, D20, D71: LED; LED_0603_1608Metric_Pad1.05x0.95mm_HandSolder; Part APTD1608SEC/J3
IC1: TPS2113ADRBR; SON65P300X300X100-9N-D; Mouser Part Number 595-TPS2113ADRBR
IC2: BGM220PC22HNA2R; Mouser Part Number 634-BGM220PC22HNA2R
J1: USB_B_Micro; USB_Micro-B_Amphenol_10103594-0001LF_Horizontal
J2: Conn_01x07_Pin; PinHeader_1x07_P2.54mm_Vertical
J3: Conn_01x06_Pin; PinHeader_1x06_P2.54mm_Vertical
J4: Conn_02x05_Odd_Even; PinHeader_2x05_P1.27mm_Vertical
J5: BATT_POS; Pin_D1.0mm_L10.0mm
J6: BATT_NEG; Pin_D1.0mm_L10.0mm
K1, K2, K3, K4, K5, K6, K7, K8, K9, K10, K11, K12, K13, K16, K17, K18, K19, K20, K21, K22, K23, K24, K25, K26, K27, K30, K31, K32, K33, K34, K35, K36, K37, K38, K39, K40, K43, K44, K45, K46, K47, K48, K49, K50, K51, K52: KEYSW; MX-Hotswap-1U
K14: KEYSW; MX-Hotswap-2U
K15, K28, K53: KEYSW; MX-Hotswap-1.5U
K29: KEYSW; MX-Hotswap-1.75U
K41, K42: KEYSW; MX-Hotswap-2.25U
K54, K55, K56, K57, K59, K60, K61, K62: KEYSW; MX-Hotswap-1.25U
K58: KEYSW; MX-Hotswap-6.25U
R1: 10k; R_0402_1005Metric
R2: 330; R_0402_1005Metric
R3, R4: 22; R_0402_1005Metric
R6, R9, R10: 1.1k; R_0402_1005Metric
R7: 750; R_0402_1005Metric
SW2: BAT_SWITCH; SLW1215865AD
TP3: Switch_OUT; TestPoint_Pad_2.5x2.5mm
TP5: 3V3; TestPoint_Pad_2.5x2.5mm
TP6: GND; TestPoint_Pad_2.5x2.5mm
TP7: IN1; TestPoint_Pad_2.5x2.5mm
TP8: VBAT; TestPoint_Pad_2.5x2.5mm
U1: TM4C123GH6PMI7; QFP50P1200X1200X160-64N
U2: TPS73633DBV; SOT-23-5
U3: Adafruit ST7735R; adafruit_st7735r
X2: 16MHz; NX5032GA16000000MHZLNCD1

Connections:
/3V3: C1.1, C2.1, C3.1, C4.1, C5.1, C6.1, C7.1, C10.1, D9.2 (A), D20.2 (A), IC2.13 (VDD), J2.5, J4.1, R1.2, R6.1, TP5.1, U1.2 (VDDA), U1.11 (VDD), U1.26 (VDD), U1.37 (VBAT), U1.42 (VDD), U1.54 (VDD), U2.5 (OUT), U3.1 (LITE), U3.9 (VCC)
/BGM220P_DEBUG_RX: IC2.15 (PA06), J3.2
/BGM220P_DEBUG_TX: IC2.14 (PA05), J3.1
/BGM_SWCLK: IC2.8 (PA01), J4.8
/BGM_SWDIO: IC2.9 (PA02), J4.7
/BGM_SWO: IC2.10 (PA03), J4.6
/BLUETOOTH_RX: IC2.5 (PB01), J3.3, U1.16 (PC4)
/BLUETOOTH_TX: IC2.4 (PB02), J3.4, U1.15 (PC5)
/EM4_WAKEUP: IC2.22 (PC00), U1.61 (PD0)
/JTAG_SWCLK_TCLK: J2.1, U1.52 (PC0_TCK_SWCLK)
/JTAG_SWDIO_TMS: J2.2, U1.51 (PC1_TMS_SWDIO)
/JTAG_SWO_TDO: D5.2 (A), D10.2 (A), D15.2 (A), D30.2 (A), D50.2 (A), D55.2 (A), D60.2 (A), D65.2 (A), J2.3, U1.49 (PC3_TDO_SWO)
/JTAG_TDI: J2.4, U1.50 (PC2_TDI)
/LCD_DC: U1.23 (PA6), U3.7 (D/C)
/LCD_MISO: U1.21 (PA4_SSI0Rx), U3.2 (MISO)
/LCD_MOSI: U1.22 (PA5_SSI0Tx), U3.4 (MOSI)
/LCD_Reset: U1.24 (PA7), U3.8 (RESET)
/LCD_SD_Card: U1.45 (PB0_USB0VID), U3.6 (CARD_CS)
/LCD_clk: U1.19 (PA2_SSI0Clk), U3.3 (SCK)
/LCD_fs: U1.20 (PA3_SSI0Fss), U3.5 (TFT_CS)
/PTI_DFRAME: IC2.27 (PC05), J4.9
/PTI_DOUT: IC2.26 (PC04), J4.10
/Switch_OUT: C15.2, IC1.7 (OUT), TP3.1, U2.1 (IN), U2.3 (EN)
/TM4C_DEBUG_RX: J3.6, U1.17 (PA0_U0Rx)
/TM4C_DEBUG_TX: J3.5, U1.18 (PA1_U0Tx)
/VBAT: C19.1, IC1.6 (IN2), SW2.2 (B), TP8.1
/VBUS: C17.1, IC1.8 (IN1), J1.1 (VBUS), R2.1, TP7.1
/col0: K1.1, K15.1, K29.1, K42.1, K55.1, U1.14 (PC6)
/col1: K2.1, K16.1, K30.1, K56.1, U1.13 (PC7)
/col2: K3.1, K17.1, K31.1, K43.1, K57.1, U1.10 (PD7)
/col3: K4.1, K18.1, K32.1, K44.1, U1.9 (PE0)
/col4: K5.1, K19.1, K33.1, K45.1, U1.8 (PE1)
/col5: K6.1, K20.1, K34.1, K46.1, K58.1, U1.7 (PE2)
/col6: K7.1, K21.1, K35.1, K47.1, U1.6 (PE3)
/col7: K8.1, K22.1, K36.1, K48.1, U1.5 (PF4)
/col8: K9.1, K23.1, K37.1, K49.1, U1.4 (PB7)
/col9: K10.1, K24.1, K38.1, K50.1, K59.1, U1.1 (PB6)
/col10: K11.1, K25.1, K39.1, K51.1, K60.1, U1.60 (PE5)
/col11: K12.1, K26.1, K40.1, K52.1, K61.1, U1.59 (PE4)
/col12: K13.1, K27.1, K53.1, K62.1, U1.58 (PB4)
/col13: K14.1, K28.1, K41.1, K54.1, U1.57 (PB5)
/row0: D1.2 (A), D6.2 (A), D11.2 (A), D16.2 (A), D21.2 (A), D26.2 (A), D31.2 (A), D36.2 (A), D41.2 (A), D46.2 (A), D51.2 (A), D56.2 (A), D61.2 (A), D66.2 (A), U1.31 (PF3)
/row1: D2.2 (A), D7.2 (A), D12.2 (A), D17.2 (A), D22.2 (A), D27.2 (A), D32.2 (A), D37.2 (A), D42.2 (A), D47.2 (A), D52.2 (A), D57.2 (A), D62.2 (A), D67.2 (A), U1.30 (PF2)
/row2: D3.2 (A), D8.2 (A), D13.2 (A), D18.2 (A), D23.2 (A), D28.2 (A), D33.2 (A), D38.2 (A), D43.2 (A), D48.2 (A), D53.2 (A), D58.2 (A), D68.2 (A), U1.29 (PF1)
/row3: D4.2 (A), D14.2 (A), D19.2 (A), D24.2 (A), D29.2 (A), D34.2 (A), D39.2 (A), D44.2 (A), D49.2 (A), D54.2 (A), D59.2 (A), D64.2 (A), D69.2 (A), U1.28 (PF0)
/~BLUETOOTH_LED: IC2.3 (PB03), R10.1
/~CAPS_LOCK_LED: R9.1, U1.62 (PD1)
/~RESET: IC2.30 (RESETN), J2.6, J4.3, R1.1, U1.38 (RST_N)
GND: BT2.-, C1.2, C2.2, C3.2, C4.2, C5.2, C6.2, C7.2, C8.2, C9.2, C10.2, C11.2, C12.2, C13.2, C14.2, C15.1, C16.2, C17.2, C19.2, D71.1 (K), IC1.2 (~EN), IC1.3 (VSNS), IC1.5 (GND_1), IC1.9 (GND_2), IC2.1 (GND_1), IC2.12 (GND_2), IC2.20 (GND_3), IC2.31 (GND_4), J1.5 (GND), J1.6 (Shield), J2.7, J4.2, J6.1, R7.2, SW2.3 (C), TP6.1, U1.3 (GNDA), U1.12 (GND), U1.27 (GND), U1.32 (WAKE_N), U1.34 (XOSC0), U1.35 (GNDX), U1.39 (GND), U1.47 (PB2_I2C0SCL), U1.48 (PB3_I2C0SDA), U1.53 (PD6), U1.55 (GND), U1.63 (PD2), U1.64 (PD3), U2.2 (GND), U3.10 (GND)
unnamed: BT1.+, BT4.-
unnamed: BT1.-, BT2.+
unnamed: C11.1, C12.1, C13.1, C14.1, U1.25 (VDDC), U1.56 (VDDC)
unnamed: D1.1 (K), K1.2
unnamed: D2.1 (K), K15.2
unnamed: D3.1 (K), K29.2
unnamed: D4.1 (K), K42.2
unnamed: D5.1 (K), K55.2
unnamed: D6.1 (K), K2.2
unnamed: D7.1 (K), K16.2
unnamed: D8.1 (K), K30.2
unnamed: D9.1 (K), R9.2
unnamed: D10.1 (K), K56.2
unnamed: D11.1 (K), K3.2
unnamed: D12.1 (K), K17.2
unnamed: D13.1 (K), K31.2
unnamed: D14.1 (K), K43.2
unnamed: D15.1 (K), K57.2
unnamed: D16.1 (K), K4.2
unnamed: D17.1 (K), K18.2
unnamed: D18.1 (K), K32.2
unnamed: D19.1 (K), K44.2
unnamed: D20.1 (K), R10.2
unnamed: D21.1 (K), K5.2
unnamed: D22.1 (K), K19.2
unnamed: D23.1 (K), K33.2
unnamed: D24.1 (K), K45.2
unnamed: D26.1 (K), K6.2
unnamed: D27.1 (K), K20.2
unnamed: D28.1 (K), K34.2
unnamed: D29.1 (K), K46.2
unnamed: D30.1 (K), K58.2
unnamed: D31.1 (K), K7.2
unnamed: D32.1 (K), K21.2
unnamed: D33.1 (K), K35.2
unnamed: D34.1 (K), K47.2
unnamed: D36.1 (K), K8.2
unnamed: D37.1 (K), K22.2
unnamed: D38.1 (K), K36.2
unnamed: D39.1 (K), K48.2
unnamed: D41.1 (K), K9.2
unnamed: D42.1 (K), K23.2
unnamed: D43.1 (K), K37.2
unnamed: D44.1 (K), K49.2
unnamed: D46.1 (K), K10.2
unnamed: D47.1 (K), K24.2
unnamed: D48.1 (K), K38.2
unnamed: D49.1 (K), K50.2
unnamed: D50.1 (K), K59.2
unnamed: D51.1 (K), K11.2
unnamed: D52.1 (K), K25.2
unnamed: D53.1 (K), K39.2
unnamed: D54.1 (K), K51.2
unnamed: D55.1 (K), K60.2
unnamed: D56.1 (K), K12.2
unnamed: D57.1 (K), K26.2
unnamed: D58.1 (K), K40.2
unnamed: D59.1 (K), K52.2
unnamed: D60.1 (K), K61.2
unnamed: D61.1 (K), K13.2
unnamed: D62.1 (K), K27.2
unnamed: D64.1 (K), K53.2
unnamed: D65.1 (K), K62.2
unnamed: D66.1 (K), K14.2
unnamed: D67.1 (K), K28.2
unnamed: D68.1 (K), K41.2
unnamed: D69.1 (K), K54.2
unnamed: D71.2 (A), R6.2
unnamed: IC1.4 (ILIM), R7.1
unnamed: J1.3 (D+), R4.2
unnamed: J1.2 (D-), R3.2
unnamed: BT4.+, J5.1, SW2.1 (A)
unnamed: C8.1, U1.40 (OSC0), X2.1
unnamed: C9.1, U1.41 (OSC1), X2.2
unnamed: R2.2, U1.46 (PB1_USB0VBUS)
unnamed: R3.1, U1.43 (PD4)
unnamed: R4.1, U1.44 (PD5)
unnamed: C16.1, U2.4 (NR)

Notes on the sheet:
Shift
Main Oscillator
Caps
JTAG Pins
Bluetooth
USB
LCD
Insert
Voltage Regulation
Backspace
Switch/Key Matrix
Tab
Enter
BGM SWD
Battery (3xAA/AAA)
Debug UART Pins
Switching Circuit (USB/Battery)
Spacebar
Power LED
LEDs
See 24.9.5 in the datasheet
Verified
Already pulled by ICDI TM4C
C14 should be placed on pin 25 C11/12/13 on pin 56
only uses like 3mA btw OMEGALUL
No reset switch necessary Just toggle the power (switch or JTAG)
Place a .1uF cap on each VDD pin 1uF and 10nF caps isolate VDD from VDDA
ILIM - Current Limit Current Limit = 500/R TPS2113A can do 630mA min limit R = 500/0.630 ~= 800 Ohm
who needs a JTAG header?
ID Grounded = HOST ID Floating = DEVICE
USB series resistors are ??? ripped from an example KB schematic probably just need to ensure 90 ohm diff impedance
PB2 is BGM220P RX PB1 is BGM220P TX BLUETOOTH_?X is relative to the TM4C
See Table 23-7 in the TM4C123 datasheet
Must have a large copper ground pour to dissipate heat properly

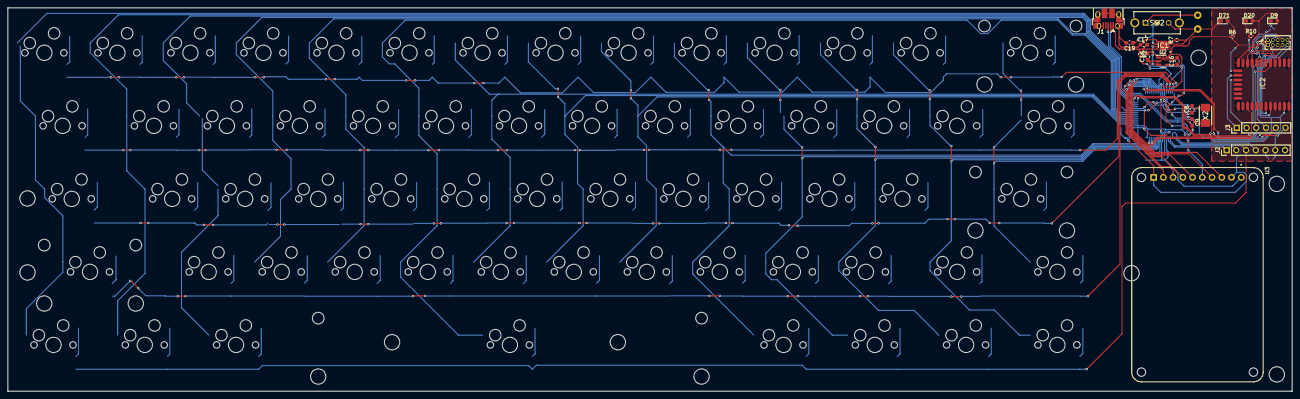
[picture p13: board KeyboardPCB.kicad_pcb from above]

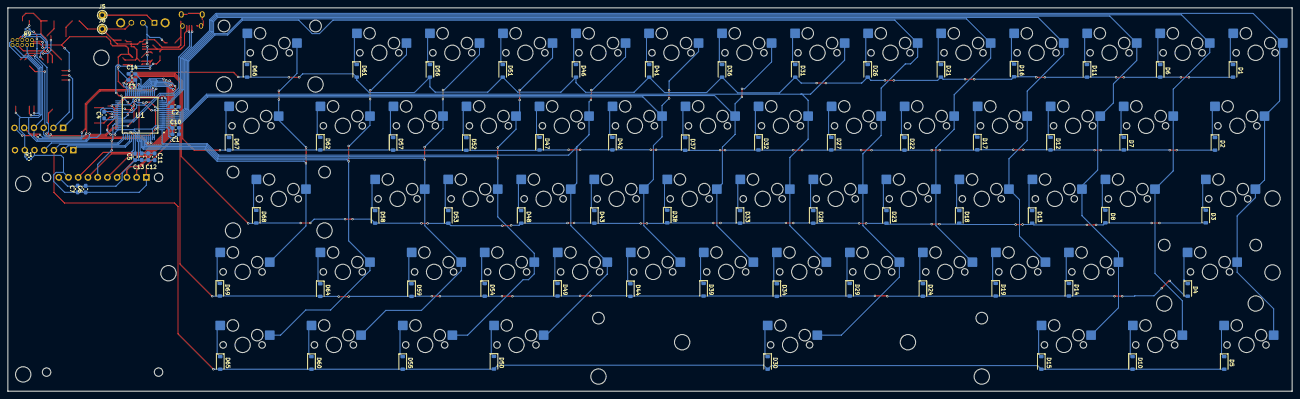
[picture p14: board KeyboardPCB.kicad_pcb from below]

Board: 2 copper layers, 335.0 x 100.0 mm, 164 parts (79 on the bottom side), 121 nets.
