MaprilBear/Keebi/sw/inc/CortexM.c

// CortexM.c
// Cortex M registers and basic functions used in these labs
// Daniel and Jonathan Valvano
// Jan 2, 2020

/* This example accompanies the books
   "Embedded Systems: Introduction to ARM Cortex M Microcontrollers",
      ISBN: 978-1469998749, Jonathan Valvano, copyright (c) 2020
   "Embedded Systems: Real Time Interfacing to ARM Cortex M Microcontrollers",
      ISBN: 978-1463590154, Jonathan Valvano, copyright (c) 2020
   "Embedded Systems: Real-Time Operating Systems for ARM Cortex-M Microcontrollers",
      ISBN: 978-1466468863, Jonathan Valvano, copyright (c) 2020

 Copyright 2020 by Jonathan W. Valvano, valvano@mail.utexas.edu
    You may use, edit, run or distribute this file
    as long as the above copyright notice remains
 THIS SOFTWARE IS PROVIDED "AS IS".  NO WARRANTIES, WHETHER EXPRESS, IMPLIED
 OR STATUTORY, INCLUDING, BUT NOT LIMITED TO, IMPLIED WARRANTIES OF
 MERCHANTABILITY AND FITNESS FOR A PARTICULAR PURPOSE APPLY TO THIS SOFTWARE.
 VALVANO SHALL NOT, IN ANY CIRCUMSTANCES, BE LIABLE FOR SPECIAL, INCIDENTAL,
 OR CONSEQUENTIAL DAMAGES, FOR ANY REASON WHATSOEVER.
 For more information about my classes, my research, and my books, see
 http://users.ece.utexas.edu/~valvano/
 */

#include <stdint.h>

//******DisableInterrupts************
// sets the I bit in the PRIMASK to disable interrupts
// Inputs: none
// Outputs: none
// implemented in startup_TM4C123.s

//******EnableInterrupts************
// clears the I bit in the PRIMASK to enable interrupts
// Inputs: none
// Outputs: none
// implemented in startup_TM4C123.s


//******StartCritical************
// StartCritical saves a copy of PRIMASK and disables interrupts
// Code between StartCritical and EndCritical is run atomically
// Inputs: none
// Outputs: copy of the PRIMASK (I bit) before StartCritical called
// implemented in startup_TM4C123.s


//******EndCritical************
// EndCritical sets PRIMASK with value passed in
// Code between StartCritical and EndCritical is run atomically
// Inputs: PRIMASK (I bit) before StartCritical called
// Outputs: none
// implemented in startup_TM4C123.s


//******WaitForInterrupt************
// enters low power sleep mode waiting for interrupt (WFI instruction)
// processor sleeps until next hardware interrupt
// returns after ISR has been run
// Inputs: none
// Outputs: none
// implemented in startup_TM4C123.s



// delay function
// which delays 3.3*ulCount cycles
// ulCount=23746 => 1ms = 23746*3.3cycle/loop/80,000
#ifdef __TI_COMPILER_VERSION__
  //Code Composer Studio Code
  void Clock_Delay(uint32_t ulCount){
  __asm (  "pdloop:  subs    r0, #1\n"
      "    bne    pdloop\n");
}

#else

#endif
  
// ------------Clock_Delay1ms------------
// Simple delay function which delays about n milliseconds.
// Inputs: n, number of msec to wait
// Outputs: none
void Clock_Delay1ms(uint32_t n){
	static uint16_t counter = 23746;
  while(n){
    while(counter--){};  // 1 msec, tuned at 80 MHz, originally part of LCD module
    n--;
  }
}
