MaprilBear/Keebi/(commit log)

2023-10-18 Initial USB Keyboard Example
    [KalmanFilter.xlsx, Lab7BOM.xlsx, OPT3101speedChoices.xlsx, SineTable.xlsx]
2023-10-20 Added PCB files, updated requirements doc, and submitted rough draft lab7 doc.
    [KeyboardPCB.kicad_pcb, KeyboardPCB.kicad_sch]
2023-10-24 Getting started on UART
2023-10-24 Made updates to schematic
2023-10-26 PCB update
    [KeyboardPCB.kicad_pcb, KeyboardPCB.kicad_sch]
2023-10-28 Added remaining footprints and aligned keys on layout
    [KeyboardPCB.kicad_pcb, KeyboardPCB.kicad_sch, Lab7BOM.xlsx]
2023-10-28 Placed a few more components under keys
    [KeyboardPCB.kicad_pcb]
2023-10-28 Updated lab report with current estimations
2023-10-28 Made outline and placed all components in position. Just need to route :)
    [KeyboardPCB.kicad_pcb, KeyboardPCB.kicad_sch]
2023-10-28 Verified regulator circuit, added LEDs based on BOM
    [KeyboardPCB.kicad_sch, Lab7BOM.xlsx]
2023-10-28 Verified TM4C pin #s and important pins, MOSC, and caps
    [KeyboardPCB.kicad_sch, Lab7BOM.xlsx, adafruit_st7735r.stp, ai_thinker_ESP8266-01.step, ti_LM4041CILPR.step, ti_TLV5618AIP.stp, vishay_IRLD024PBF.stp]
2023-10-29 Verified LCD, power mux, JTAG, USB, and switch matrix
    Also changed the switch matrix to use hotswap footprints
    [KeyboardPCB.kicad_pcb, KeyboardPCB.kicad_sch]
2023-10-29 Pray to your ECE god of choice
    [KeyboardPCB.csv, KeyboardPCB.kicad_pcb, KeyboardPCB.kicad_sch, Lab7BOM.xlsx]
2023-10-30 6 traces to go :)
    [KeyboardPCB.kicad_pcb]
2023-10-30 Slight tweaks
    [KeyboardPCB.kicad_pcb, KeyboardPCB.kicad_sch, Lab7BOM.xlsx]
2023-10-30 Routed up remaining traces
    [KeyboardPCB.kicad_pcb]
2023-10-30 Added EM4_WAKEUP signal from PD0 (TM4C) to PC0 (BGM)
    [KeyboardPCB.kicad_pcb, KeyboardPCB.kicad_sch]
2023-10-30 pushing the backups that were created cause I'm so used to hitting ctrl+s :/
    [KeyboardPCB.kicad_pcb]
2023-10-31 Updated BoM to include LEDs and M2x4 mounting screws.
    Length of screws can be updated depending on the thickness of the PCB
    Also updated resistor values based on forward voltage of SMD LEDs
    [KeyboardPCB.kicad_pcb, KeyboardPCB.kicad_sch, Lab7BOM.xlsx]
2023-11-02 PCB done!
    [KeyboardPCB-B_Cu.gbr, KeyboardPCB-B_Mask.gbr, KeyboardPCB-B_Paste.gbr, KeyboardPCB-B_SilkS.gbr, KeyboardPCB-Edge_Cuts.gbr, KeyboardPCB-F_Cu.gbr, KeyboardPCB-F_Mask.gbr, KeyboardPCB-F_Paste.gbr]
2023-11-03 added some basic unit testing procedures (for lab 8 report) for once pcb arrives
    [Lab7BOM.xlsx]
2023-11-04 Accidentally deleted final PCB, oops
    Old version from before last minute tuesday edits
    [KeyboardPCB.kicad_pcb]
2023-11-10 Routed row4 to JTAG_TDO
    [KeyboardPCB.kicad_pcb, KeyboardPCB.kicad_sch]
2023-11-16 Undo what i did that makes it not work on all devices
    [CortexM.c]
2023-11-17 Made ESC default and fixed CAPS_LOCK
2023-12-02 BOM Update
    [Lab7BOM.xlsx]
2023-12-02 Cleanup and updated README
    [BOM.xlsx, Lab7BOM.xlsx, adafruit_st7735r.stp, ai_thinker_ESP8266-01.step, baseline_project.kicad_pcb, baseline_project.kicad_sch, bom.csv, designators.csv]
2024-08-15 Rename Keebi PCB.png to KeebiPCB.png
