MaprilBear/Keebi/(notices)

Notices in the files:
sw/inc/Sine.h:
Copyright 2014 by Jonathan W. Valvano, valvano@mail.utexas.edu
